MarcinWojewodzic/C3V1_InDoorWeatheStation/Hardware/PrototypV1_tx/PrototypV1_tx.kicad_pcb

## KiCad design Hardware/PrototypV1_tx/PrototypV1_tx.kicad_pcb (2022-09-23)

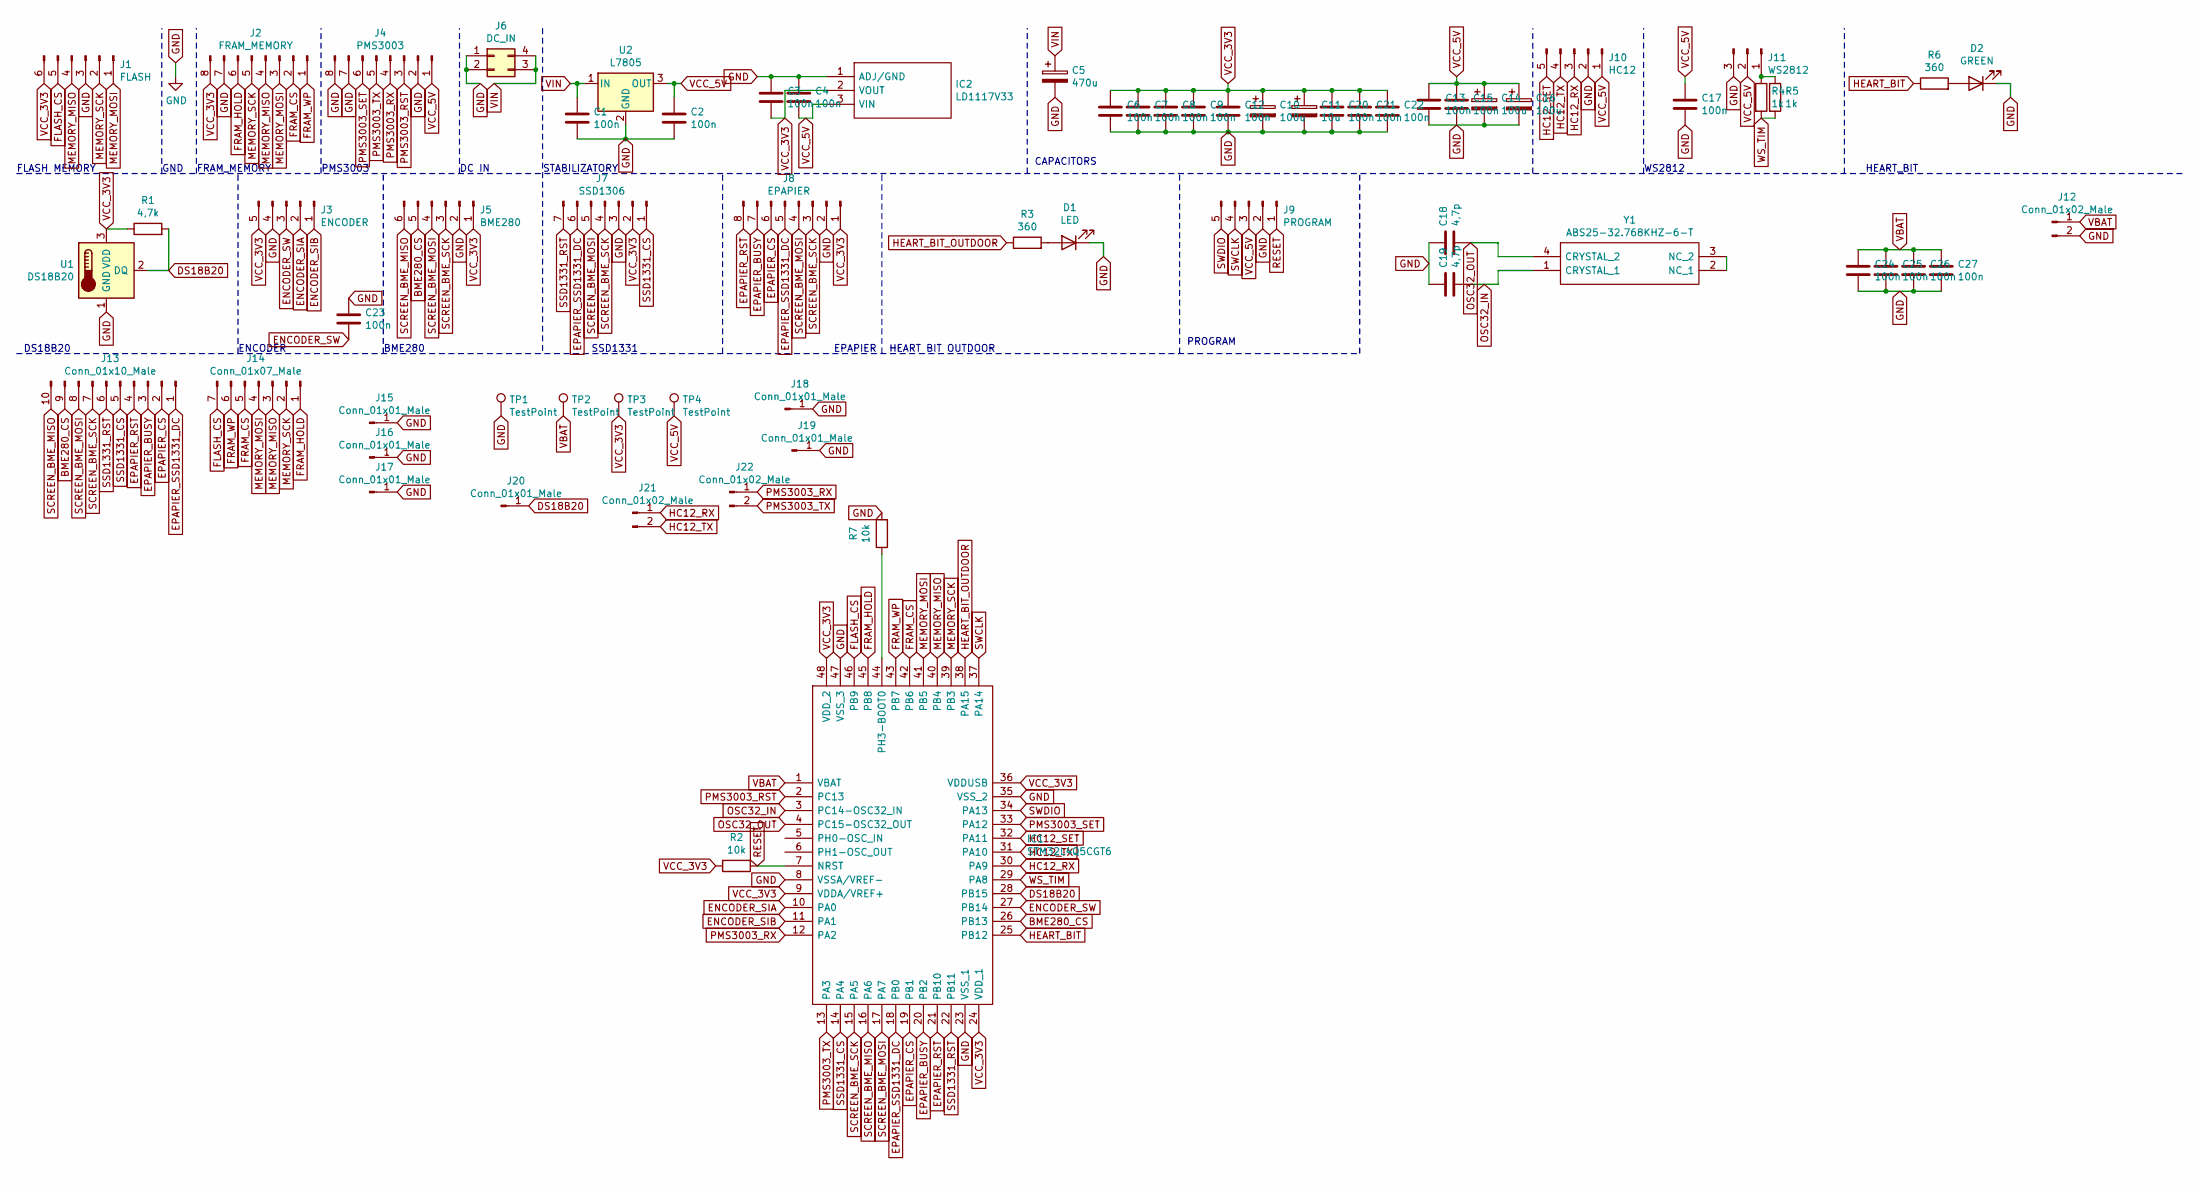
[picture p1: schematic PrototypV1_tx.sch]

Parts:
C1, C2, C3, C4, C6, C7, C8, C9, C12, C13, C15, C17, C20, C21, C22, C23, C24, C25, C26, C27: 100n; C_1206_3216Metric_Pad1.33x1.80mm_HandSolder
C5: 470u; CP_Elec_8x10.5
C10, C14, C16: 100u; CP_Elec_5x5.4
C11: 10u; CP_Elec_4x5.4
C18, C19: 4,7p; C_1206_3216Metric_Pad1.33x1.80mm_HandSolder
D1: LED; LED_1206_3216Metric_Pad1.42x1.75mm_HandSolder
D2: GREEN; LED_1206_3216Metric_Pad1.42x1.75mm_HandSolder
IC1: STM32L4Q5CGT6; QFP50P900X900X160-48N; Manufacturer_Part_Number STM32L4Q5CGT6; Mouser Part Number 511-STM32L4Q5CGT6
IC2: LD1117V33; TO-220-3_Vertical; Manufacturer_Part_Number LD1117V33; Mouser Part Number 511-LD1117V33
J1: FLASH; PinHeader_1x06_P2.54mm_Vertical
J2: FRAM_MEMORY; PinHeader_1x08_P2.54mm_Vertical
J3: ENCODER; PinHeader_1x05_P2.54mm_Vertical
J4: PMS3003; PinHeader_1x08_P2.54mm_Vertical
J5: BME280; PinHeader_1x06_P2.54mm_Vertical
J6: DC_IN; PinHeader_2x02_P2.54mm_Vertical
J7: SSD1306; PinSocket_1x07_P2.54mm_Vertical
J8: EPAPIER; PinHeader_1x08_P2.54mm_Vertical
J9: PROGRAM; PinHeader_1x05_P2.54mm_Vertical
J10: HC12; PinHeader_1x05_P2.54mm_Vertical
J11: WS2812; PinHeader_1x03_P2.54mm_Vertical
J12, J21, J22: Conn_01x02_Male; PinHeader_1x02_P2.54mm_Vertical
J13: Conn_01x10_Male; PinHeader_1x10_P2.54mm_Vertical
J14: Conn_01x07_Male; PinHeader_1x07_P2.54mm_Vertical
J15, J16, J17, J18, J19, J20: Conn_01x01_Male; PinHeader_1x01_P2.54mm_Vertical
R1: 4,7k; R_1206_3216Metric_Pad1.30x1.75mm_HandSolder
R2, R7: 10k; R_1206_3216Metric_Pad1.30x1.75mm_HandSolder
R3, R6: 360; R_1206_3216Metric_Pad1.30x1.75mm_HandSolder
R4, R5: 1k; R_1206_3216Metric_Pad1.30x1.75mm_HandSolder
TP1, TP2, TP3, TP4: TestPoint; TestPoint_Pad_2.0x2.0mm
U1: DS18B20; TO-92_Inline
U2: L7805; TO-220-3_Vertical
Y1: ABS25-32.768KHZ-6-T; ABS2532768KHZT; Manufacturer_Part_Number ABS25-32.768KHZ-6-T; Mouser Part Number 815-ABS25-32.768K6-T

Connections:
BME280_CS: IC1.26 (PB13), J5.5, J13.9
DS18B20: IC1.28 (PB15), J20.1, R1.2, U1.2 (DQ)
ENCODER_SIA: IC1.10 (PA0), J3.2
ENCODER_SIB: IC1.11 (PA1), J3.1
ENCODER_SW: C23.2, IC1.27 (PB14), J3.3
EPAPIER_BUSY: IC1.20 (PB2), J8.7, J13.3
EPAPIER_CS: IC1.19 (PB1), J8.6, J13.2
EPAPIER_RST: IC1.21 (PB10), J8.8, J13.4
EPAPIER_SSD1331_DC: IC1.18 (PB0), J7.6, J8.5, J13.1
FLASH_CS: IC1.46 (PB9), J1.5, J14.7
FRAM_CS: IC1.42 (PB6), J2.2, J14.5
FRAM_HOLD: IC1.45 (PB8), J2.6, J14.1
FRAM_WP: IC1.43 (PB7), J2.1, J14.6
GND: C1.2, C2.2, C3.1, C4.1, C5.2, C6.2, C7.2, C8.2, C9.2, C10.2, C11.2, C12.2, C13.2, C14.2, C15.2, C16.2, C17.2, C18.1, C19.1, C20.2, C21.2, C22.2, C23.1, C24.2, C25.2, C26.2, C27.2, D1.1 (K), D2.1 (K), IC1.8 (VSSA/VREF-), IC1.23 (VSS_1), IC1.35 (VSS_2), IC1.47 (VSS_3), IC2.1 (ADJ/GND), J1.3, J2.7, J3.4, J4.2, J4.7, J4.8, J5.2, J6.1, J6.2, J7.3, J8.2, J9.2, J10.2, J11.3, J12.2, J15.1, J16.1, J17.1, J18.1, J19.1, R7.2, TP1.1, U1.1 (GND), U2.2 (GND)
HC12_RX: IC1.30 (PA9), J10.3, J21.1
HC12_SET: IC1.32 (PA11), J10.5
HC12_TX: IC1.31 (PA10), J10.4, J21.2
HEART_BIT: IC1.25 (PB12), R6.1
HEART_BIT_OUTDOOR: IC1.38 (PA15), R3.1
MEMORY_MISO: IC1.40 (PB4), J1.4, J2.4, J14.3
MEMORY_MOSI: IC1.41 (PB5), J1.1, J2.3, J14.4
MEMORY_SCK: IC1.39 (PB3), J1.2, J2.5, J14.2
unnamed: D1.2 (A), R3.2
unnamed: D2.2 (A), R6.2
unnamed: IC1.44 (PH3-BOOT0), R7.1
unnamed: J11.1, R4.1, R5.1
unnamed: Y1.2 (NC_1), Y1.3 (NC_2)
OSC32_IN: C19.2, IC1.3 (PC14-OSC32_IN), Y1.1 (CRYSTAL_1)
OSC32_OUT: C18.2, IC1.4 (PC15-OSC32_OUT), Y1.4 (CRYSTAL_2)
PMS3003_RST: IC1.2 (PC13), J4.3
PMS3003_RX: IC1.12 (PA2), J4.4, J22.1
PMS3003_SET: IC1.33 (PA12), J4.6
PMS3003_TX: IC1.13 (PA3), J4.5, J22.2
RESET: IC1.7 (NRST), J9.1, R2.1
SCREEN_BME_MISO: IC1.16 (PA6), J5.6, J13.10
SCREEN_BME_MOSI: IC1.17 (PA7), J5.4, J7.5, J8.4, J13.8
SCREEN_BME_SCK: IC1.15 (PA5), J5.3, J7.4, J8.3, J13.7
SSD1331_CS: IC1.14 (PA4), J7.1, J13.5
SSD1331_RST: IC1.22 (PB11), J7.7, J13.6
SWCLK: IC1.37 (PA14), J9.4
SWDIO: IC1.34 (PA13), J9.5
VBAT: C24.1, C25.1, C26.1, C27.1, IC1.1 (VBAT), J12.1, TP2.1
VCC_3V3: C3.2, C6.1, C7.1, C8.1, C9.1, C10.1, C11.1, C12.1, C20.1, C21.1, C22.1, IC1.9 (VDDA/VREF+), IC1.24 (VDD_1), IC1.36 (VDDUSB), IC1.48 (VDD_2), IC2.2 (VOUT), J1.6, J2.8, J3.5, J5.1, J7.2, J8.1, R1.1, R2.2, TP3.1, U1.3 (VDD)
VCC_5V: C2.1, C4.2, C13.1, C14.1, C15.1, C16.1, C17.1, IC2.3 (VIN), J4.1, J9.3, J10.1, J11.2, TP4.1, U2.3 (OUT)
VIN: C1.1, C5.1, J6.3, J6.4, U2.1 (IN)
WS_TIM: IC1.29 (PA8), R4.2, R5.2

Notes on the sheet:
FLASH MEMORY
GND
FRAM_MEMORY
PMS3003
DC IN
STABILIZATORY
CAPACITORS
WS2812
HEART_BIT
DS18B20
ENCODER
BME280
SSD1331
EPAPIER
HEART BIT OUTDOOR
PROGRAM

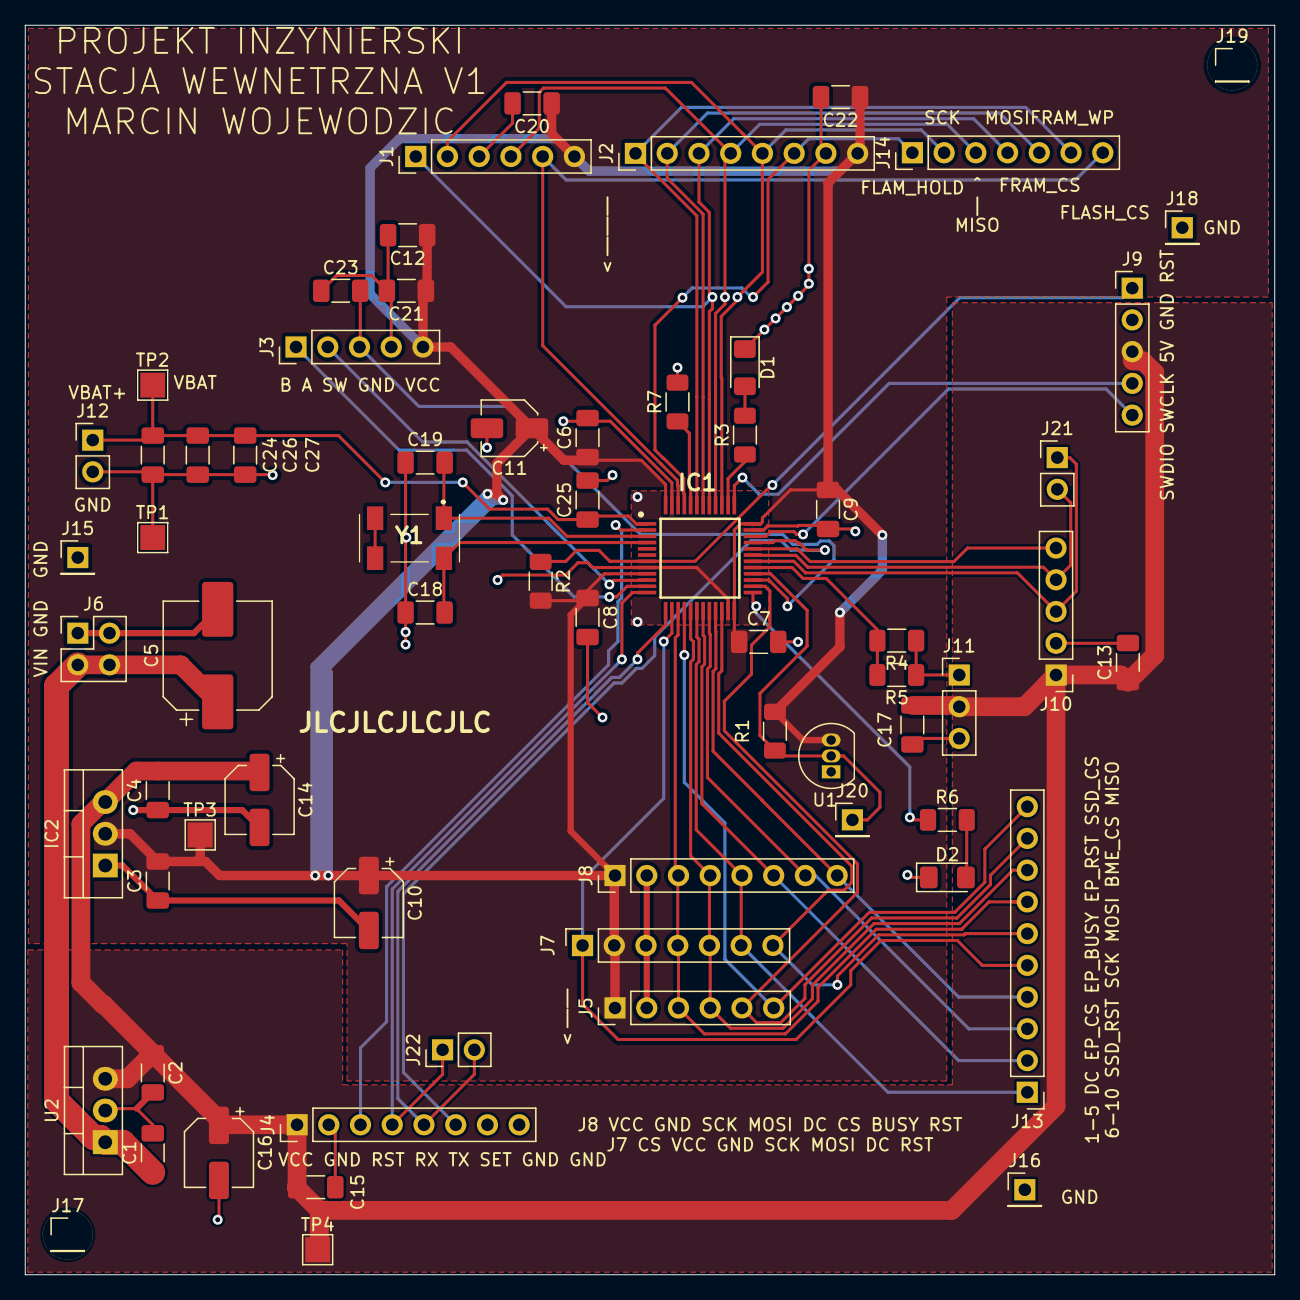
[picture p2: board PrototypV1_tx.kicad_pcb from above]

Board: 2 copper layers, 100.0 x 100.0 mm, 67 parts (0 on the bottom side), 46 nets.
