MarcinWojewodzic/C3V1_InDoorWeatheStation/Firmware/C3V1_InDoorWeatherStation/Core/Src/main.c

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
/* Includes ------------------------------------------------------------------*/
#include "main.h"
#include "dma.h"
#include "rng.h"
#include "rtc.h"
#include "spi.h"
#include "tim.h"
#include "usart.h"
#include "gpio.h"

/* USER CODE BEGIN Includes */
#include "GFX_BW.h"
#include "e_papier.h"
#include "flash_spi.h"
#include "fonts/fonts.h"
#include "fram.h"
#include "rfp.h"
#include "ssd1306_spi.h"
#include <stdio.h>
#include <stdlib.h>
/* USER CODE END Includes */


/* USER CODE BEGIN PV */
// fram_t fram1;
// RFP_TypeDef rfp;
// flash_t flash1;
/* USER CODE END PV */

void SystemClock_Config(void);
static void MX_NVIC_Init(void);
/* USER CODE BEGIN PFP */
void RFP_DataFunction(uint8_t *Data, uint32_t DataLength, uint32_t DataStart);
void RFP_MessageExitDeepSleep(uint8_t *Data, uint32_t DataLength, uint32_t DataStart);
float h, t, b;
uint16_t pm1, pm25, pm10;
uint8_t f = 0;
RTC_TimeTypeDef RtcTime;
RTC_DateTypeDef RtcDate;
uint8_t State;
RFP_TypeDef rfp;
fram_t fram1;
flash_t flash1;
/* USER CODE END PFP */

/**
  * @brief  The application entry point.
  * @retval int
  */
int main(void)
{
  /* MCU Configuration--------------------------------------------------------*/

  /* Reset of all peripherals, Initializes the Flash interface and the Systick. */
  HAL_Init();

  /* Configure the system clock */
  SystemClock_Config();

  /* Initialize all configured peripherals */
  MX_GPIO_Init();
  MX_DMA_Init();
  MX_TIM1_Init();
  MX_TIM2_Init();
  MX_USART1_UART_Init();
  MX_TIM5_Init();
  MX_USART2_UART_Init();
  MX_SPI1_Init();
  MX_RTC_Init();
  MX_RNG_Init();

  /* Initialize interrupts */
  MX_NVIC_Init();
  /* USER CODE BEGIN 2 */
   ssd1306_init(&hspi1);
   ssd1306_clear();
   ssd1306_display();
   GFX_SetFont(font_8x5);
   GFX_DrawString(0, 50, "abcdef", WHITE, 0, OLED);
   ssd1306_display();
   e_papier_init(&hspi1);
   e_papier_display();
   ssd1306_display();
   fram_Init(&fram1, &hspi1, FRAM_HOLD_GPIO_Port, FRAM_CS_GPIO_Port, FRAM_WP_GPIO_Port, FRAM_HOLD_Pin, FRAM_CS_Pin, FRAM_WP_Pin);
   RFP_Init(&rfp, RFP_IDWS);
   flash_Init(&flash1, &hspi1, FLASH_CS_GPIO_Port, FLASH_CS_Pin);
   RFP_RegisterDataFunction(RFP_DataFunction);
   RFP_RegisterMessageFunction(RFP_EXIT_DEEP_SLEEP, RFP_MessageExitDeepSleep);
   uint8_t data = RFP_START_MEASURMENT;
   RFP_SendData(RFP_ODWS, RFP_COMMAND, &data, 1);
   HAL_TIM_Encoder_Start(&htim5, TIM_CHANNEL_ALL);
   uint32_t Time = 0;
  /* USER CODE END 2 */

  /* Infinite loop */
  /* USER CODE BEGIN WHILE */
   while(1)
   {
      if(HAL_GetTick() - Time > 1000)
      {
         ssd1306_clear();
         Time = HAL_GetTick();
         HAL_RTC_GetTime(&hrtc, &RtcTime, RTC_FORMAT_BIN);
         HAL_RTC_GetDate(&hrtc, &RtcDate, RTC_FORMAT_BIN);
         char data[100];
         sprintf(data, "%d h %d m %d s", RtcTime.Hours, RtcTime.Minutes, RtcTime.Seconds);
         GFX_DrawString(0, 0, data, WHITE, 0, OLED);
         sprintf(data, "%d : %d ; 2022", RtcDate.Date, RtcDate.Month);
         GFX_DrawString(0, 10, data, WHITE, 0, OLED);
         ssd1306_display();
      }
      RFP_Handle();
      if(f == 1)
      {
         f = 0;
         char mes[100];
         sprintf(mes, "H %0.2f", h);
         GFX_DrawString(0, 0, mes, BLACK, 1, E_PAPIER);
         sprintf(mes, "T %0.2f", t);
         GFX_DrawString(0, 10, mes, BLACK, 1, E_PAPIER);
         sprintf(mes, "PM1 %d", pm1);
         GFX_DrawString(0, 20, mes, BLACK, 1, E_PAPIER);
         sprintf(mes, "PM10 %d", pm10);
         GFX_DrawString(0, 30, mes, BLACK, 1, E_PAPIER);
         sprintf(mes, "PM2,5 %d", pm25);
         GFX_DrawString(0, 40, mes, BLACK, 1, E_PAPIER);
         sprintf(mes, "Battery Level %0.2f", b);
         GFX_DrawString(0, 50, mes, BLACK, 1, E_PAPIER);
         if(!(State & 0x01))
         {
            GFX_DrawString(0, 60, "Battery Charging", BLACK, 1, E_PAPIER);
         }
         else
         {
            GFX_DrawString(0, 60, "Battery No Charging", BLACK, 1, E_PAPIER);
         }
         if(!(State & 0x02))
         {
            GFX_DrawString(0, 70, "Battery Standby", BLACK, 1, E_PAPIER);
         }
         else
         {
            GFX_DrawString(0, 70, "Battery No Standby", BLACK, 1, E_PAPIER);
         }
         HAL_RTC_GetTime(&hrtc, &RtcTime, RTC_FORMAT_BIN);
         HAL_RTC_GetDate(&hrtc, &RtcDate, RTC_FORMAT_BIN);
         sprintf(mes, "%d h %d m %d s", RtcTime.Hours, RtcTime.Minutes, RtcTime.Seconds);
         GFX_DrawString(0, 80, mes, BLACK, 1, E_PAPIER);
         sprintf(mes, "%d : %d ; 2022", RtcDate.Date, RtcDate.Month);
         GFX_DrawString(0, 90, mes, BLACK, 1, E_PAPIER);
         e_papier_display();
         e_papier_clear();
         HAL_Delay(10000);
         //RFP_SendData(RFP_ODWS, RFP_COMMAND, &data, 1);
      }
    /* USER CODE END WHILE */

    /* USER CODE BEGIN 3 */
   }
  /* USER CODE END 3 */
}

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
/* USER CODE BEGIN 4 */
void RFP_DataFunction(uint8_t *Data, uint32_t DataLength, uint32_t DataStart)
{
   uint8_t *TempPtr;
   TempPtr  = &h;
   *TempPtr = Data[DataStart];
   TempPtr++;
   *TempPtr = Data[DataStart + 1];
   TempPtr++;
   *TempPtr = Data[DataStart + 2];
   TempPtr++;
   *TempPtr = Data[DataStart + 3];
   TempPtr++;
   TempPtr  = &t;
   *TempPtr = Data[DataStart + 5];
   TempPtr++;
   *TempPtr = Data[DataStart + 6];
   TempPtr++;
   *TempPtr = Data[DataStart + 7];
   TempPtr++;
   *TempPtr = Data[DataStart + 8];
   TempPtr  = &b;
   *TempPtr = Data[DataStart + 13];
   TempPtr++;
   *TempPtr = Data[DataStart + 14];
   TempPtr++;
   *TempPtr = Data[DataStart + 15];
   TempPtr++;
   *TempPtr        = Data[DataStart + 16];
   TempPtr         = NULL;
   pm1             = (Data[22 + 3] | (Data[21 + 3] << 8));
   pm25            = (Data[28 + 3] | (Data[27 + 3] << 8));
   pm10            = (Data[25 + 3] | (Data[24 + 3] << 8));
   State           = Data[DataStart + 18];
   f               = 1;
   uint8_t Temp[2] = { RFP_GO_TO_DEEP_SLEEP, 5 };
   RFP_SendData(RFP_ODWS, RFP_COMMAND, Temp, 2);
}
void RFP_MessageExitDeepSleep(uint8_t *Data, uint32_t DataLength, uint32_t DataStart)
{
   uint8_t data = RFP_START_MEASURMENT;
   RFP_SendData(RFP_ODWS, RFP_COMMAND, &data, 1);
}
void HAL_UARTEx_RxEventCallback(UART_HandleTypeDef *huart, uint16_t Size)
{
   HAL_GPIO_TogglePin(HEARTBEAT_GPIO_Port, HEARTBEAT_Pin);
   rfp.DataSize = Size;
   RFP_InterruptTask();
}
/* USER CODE END 4 */
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
