MarcinWojewodzic/C3V1_InDoorWeatheStation/Firmware/C3V1-RTOS/C3V1-RTOS.ioc

Mcu.UserName=STM32L4P5CGTx
PA0.Signal=S_TIM5_CH1
PA1.Signal=S_TIM5_CH2
PA10.Signal=USART1_RX
PA11.GPIO_Label=HC12_SET
PA11.Signal=GPIO_Output
PA12.GPIO_Label=PMS3003_RST
PA12.Signal=GPIO_Output
PA2.Signal=USART2_TX
PA3.Signal=USART2_RX
PA4.GPIO_Label=SSD1306_CS
PA4.Signal=GPIO_Output
PA5.Signal=SPI1_SCK
PA6.Signal=SPI1_MISO
PA7.Signal=SPI1_MOSI
PA8.Signal=S_TIM1_CH1
PA9.Signal=USART1_TX
PB0.GPIO_Label=SCREENS_DC
PB0.Signal=GPIO_Output
PB1.GPIO_Label=EPAPIER_CS
PB1.Signal=GPIO_Output
PB10.GPIO_Label=EPAPIER_RST
PB10.Signal=GPIO_Output
PB11.GPIO_Label=SSD1306_RST
PB11.Signal=GPIO_Output
PB12.GPIO_Label=HEARTBEAT
PB12.Signal=GPIO_Output
PB13.GPIO_Label=BME280_CS
PB13.Signal=GPIO_Output
PB14.GPIO_Label=ENCODER_SWITCH
PB14.Signal=GPIO_Input
PB15.GPIO_Label=PMS3003_SET
PB15.Signal=GPIO_Output
PB2.GPIO_Label=EPAPIER_BUSY
PB2.Signal=GPIO_Input
PB6.GPIO_Label=FRAM_CS
PB6.Signal=GPIO_Output
PB7.GPIO_Label=FRAM_WP
PB7.Signal=GPIO_Output
PB8.GPIO_Label=FRAM_HOLD
PB8.Signal=GPIO_Output
PB9.GPIO_Label=FLASH_CS
PB9.Signal=GPIO_Output
