MarcinWojewodzic/C3V1_InDoorWeatheStation/Firmware/C3V1-RTOS/Core/Src/PMS.c

/*
 * PMS.c
 *
 *  Created on: Nov 6, 2022
 *      Author: M
 */
#include "PMS.h"
#include "cmsis_os.h"
#include "main.h"
#include "usart.h"
void PMS_Reset(void)
{
   HAL_GPIO_WritePin(PMS3003_RST_GPIO_Port, PMS3003_RST_Pin, 0);
   osDelay(1000);
   HAL_GPIO_WritePin(PMS3003_RST_GPIO_Port, PMS3003_RST_Pin, 1);
}
#ifndef DEBUG_SWCLK
void PMS_ReceiveToIdle(uint8_t *Data, uint32_t Length)
{
   HAL_UARTEx_ReceiveToIdle_DMA(&huart2, Data, Length);
}
#endif
void PMS_EnterSleepMode(void)
{
   HAL_GPIO_WritePin(PMS3003_SET_GPIO_Port, PMS3003_SET_Pin, 0);
}
void PMS_ExitSleepMode(void)
{
   HAL_GPIO_WritePin(PMS3003_SET_GPIO_Port, PMS3003_SET_Pin, 1);
}
