MarcinWojewodzic/C3V1_InDoorWeatheStation/Firmware/C3V1-RTOS/Core/Inc/FlagsDefinition.h

/*
 * FlagsDefinition.h
 *
 *  Created on: Dec 24, 2022
 *      Author: M
 */

#ifndef FLAGSDEFINITION_H_
#define FLAGSDEFINITION_H_
#define SEND_MEASURMENT_COMMAND_FLAG 0x00000001
#define INITIALIZE_ALL_FLAG          0x00000002
#define E_PAPIER_DRAWING_FLAG        0x00000004
#define E_PAPIER_DISPLAY_FLAG        0x00000008
#define MOON_PHASE_FLAG              0x00000010
#define NEW_DAY_TO_SAVE              0x00000020
#define E_PAPIER_DARK_MODE           0x00000040
#define NEW_DAY_FLAG                 0x00000080
#endif /* FLAGSDEFINITION_H_ */
