MarcinWojewodzic/C3V1_InDoorWeatheStation/Firmware/C3V1-RTOS/Core/Inc/WS2812b.h

/*
 * WS2812b.h
 *
 *  Created on: Jan 15, 2023
 *      Author: M
 */

#ifndef INC_WS2812B_H_
#define INC_WS2812B_H_
#define zero 53
#define one  96
void WS2812_SetPixel(uint8_t r, uint8_t g, uint8_t b);
#endif /* INC_WS2812B_H_ */
