MarcinWojewodzic/C3V1_InDoorWeatheStation/Firmware/C3V1-RTOS/Core/Inc/FramOrganization.h

/*
 * FramOrganization.h
 *
 *  Created on: Jan 6, 2023
 *      Author: M
 */

#ifndef INC_FRAMORGANIZATION_H_
#define INC_FRAMORGANIZATION_H_
#define LAST_PAGE_NUMBER_ADDR 0x0000
#define LAST_PAGE_NUMBER_SIZE 4
#define DATE_CHART_CNT_ADDR   0x0004
#define DATE_CHART_ADDR_START 0x0008
#define DATE_CHART_ADDR_END 0x1778
#endif /* INC_FRAMORGANIZATION_H_ */
