MarcinWojewodzic/C3V1_InDoorWeatheStation/(notices)

Notices in the files:
Firmware/C3V1-RTOS/Core/Inc/main.h:
Copyright (c) 2022 STMicroelectronics.
All rights reserved.
This software is licensed under terms that can be found in the LICENSE file
